atechdotdev/Atech-crab/atech/cad/review.png

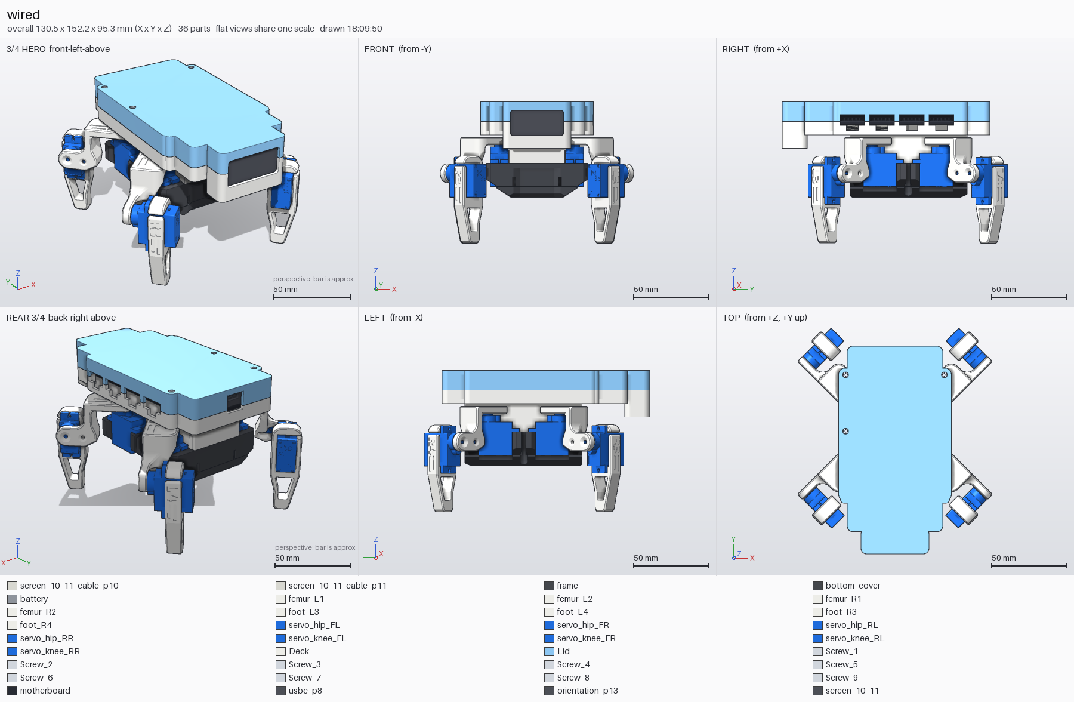
atech/cad/review.png
