atechdotdev/Atech-crab/atech/docs/img/rear.png

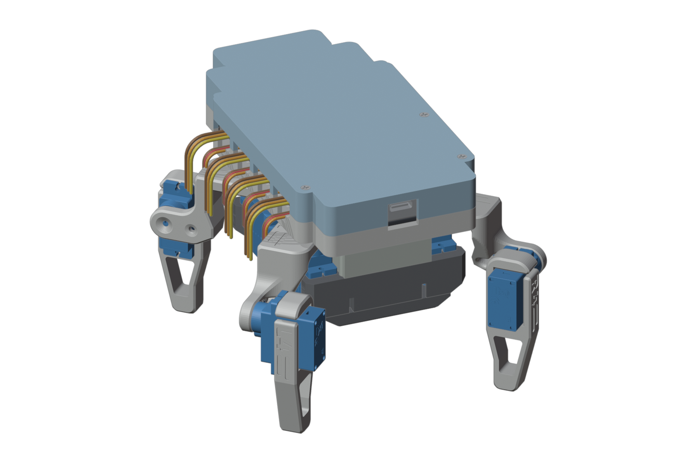
atech/docs/img/rear.png
