atechdotdev/Atech-crab/atech/docs/img/s1_base.png

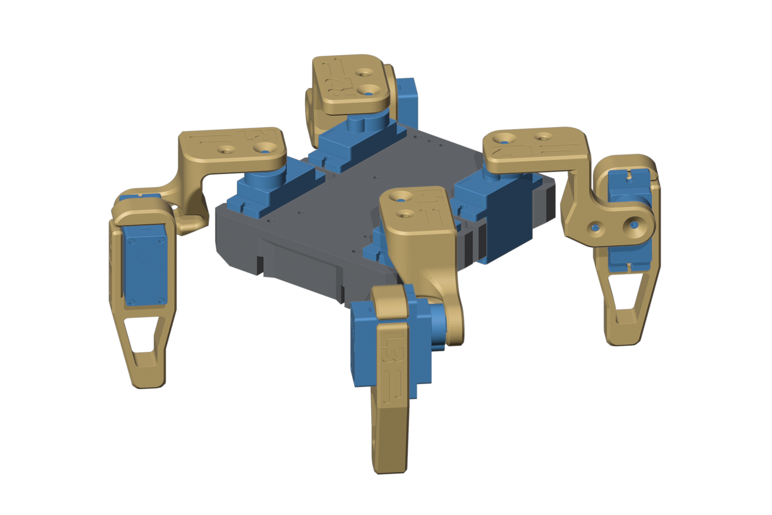
atech/docs/img/s1_base.png
