atechdotdev/Atech-crab/atech/docs/img/s2_glue.png

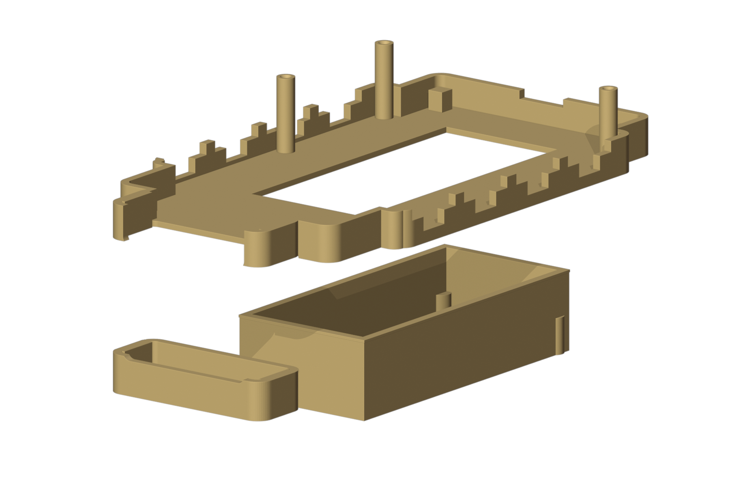
atech/docs/img/s2_glue.png
