atechdotdev/Atech-crab/atech/docs/img/s3_deck.png

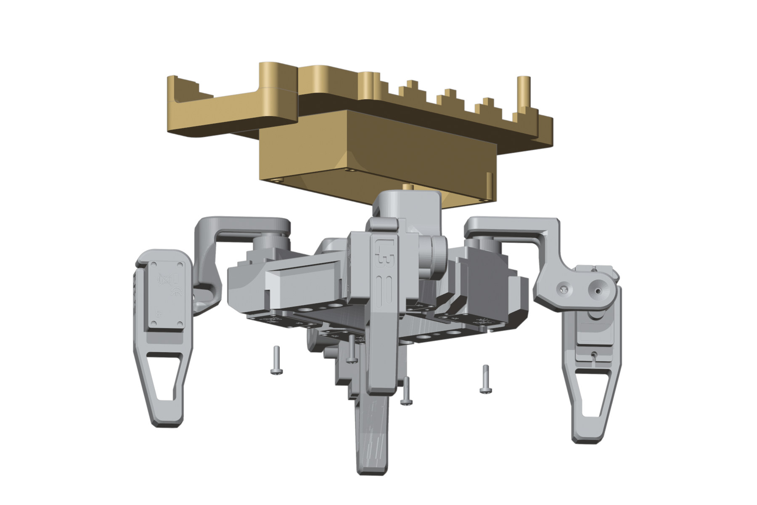
atech/docs/img/s3_deck.png
