atechdotdev/Atech-crab/atech/docs/img/s4_bottom.png

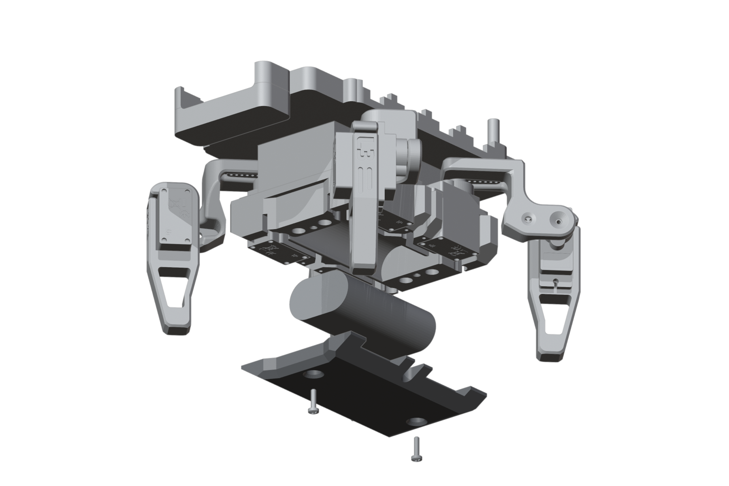
atech/docs/img/s4_bottom.png
