atechdotdev/Atech-crab/atech/docs/img/s5_board.png

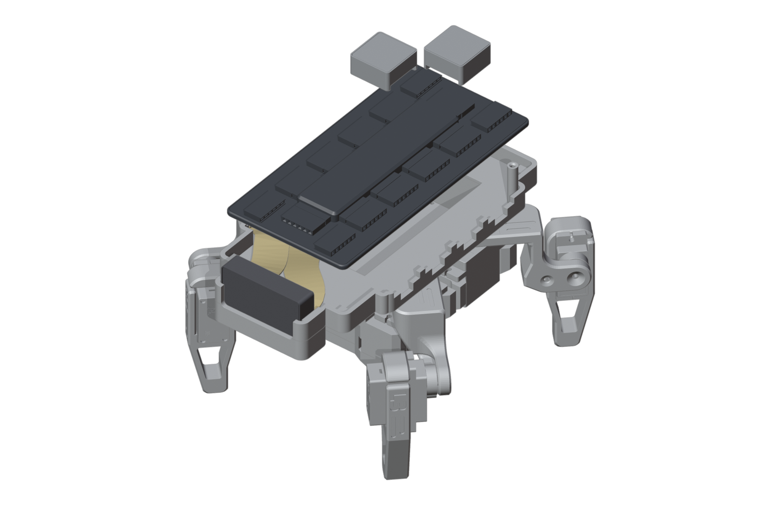
atech/docs/img/s5_board.png
