atechdotdev/Atech-crab/atech/docs/img/s6_slots_left.png

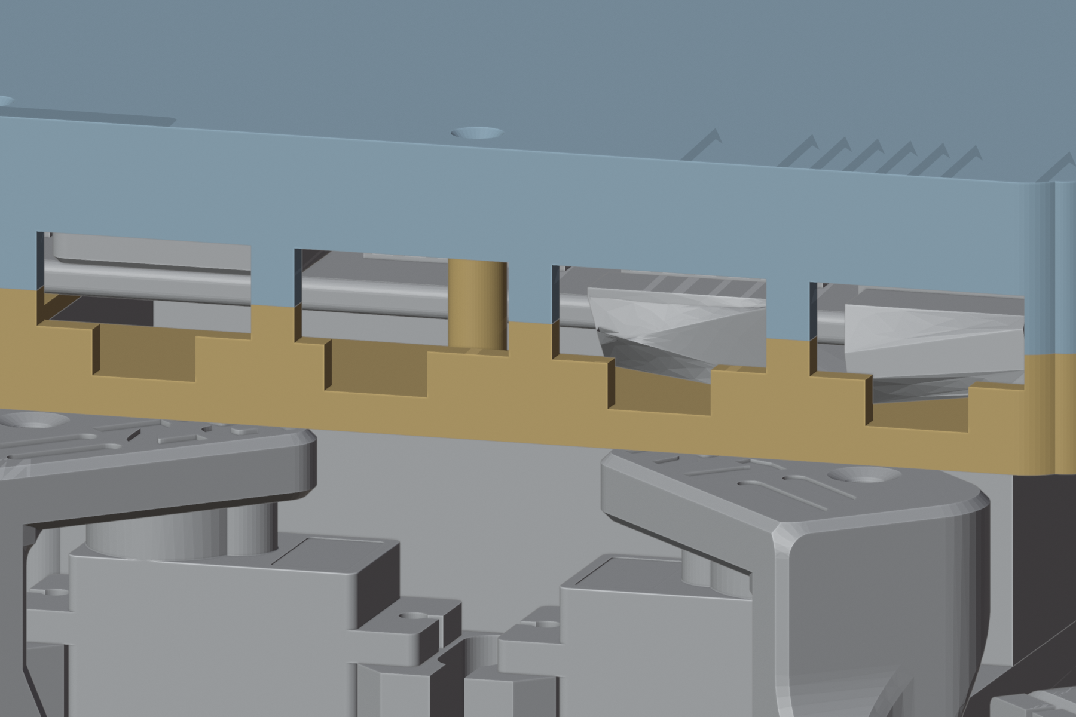
atech/docs/img/s6_slots_left.png
