atechdotdev/Atech-crab/atech/docs/img/s6_wires.png

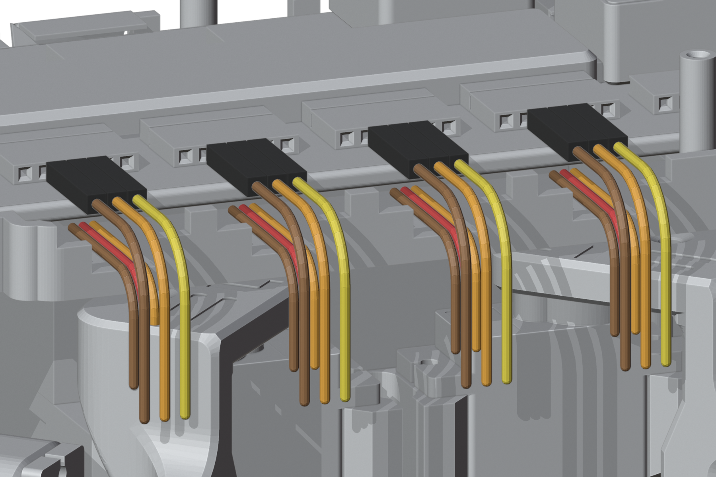
atech/docs/img/s6_wires.png
