atechdotdev/Atech-crab/atech/docs/img/s7_lid.png

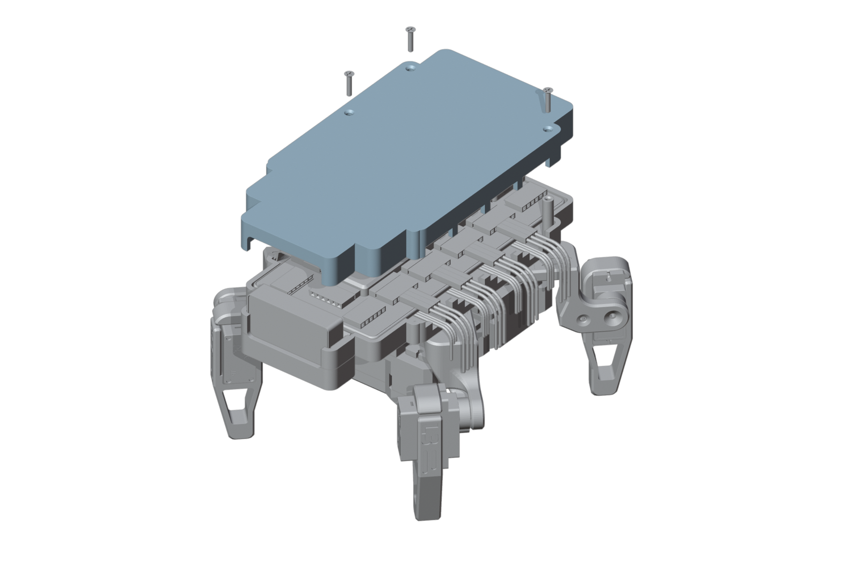
atech/docs/img/s7_lid.png
