atechdotdev/Atech-crab/atech/docs/img/s7_usb.png

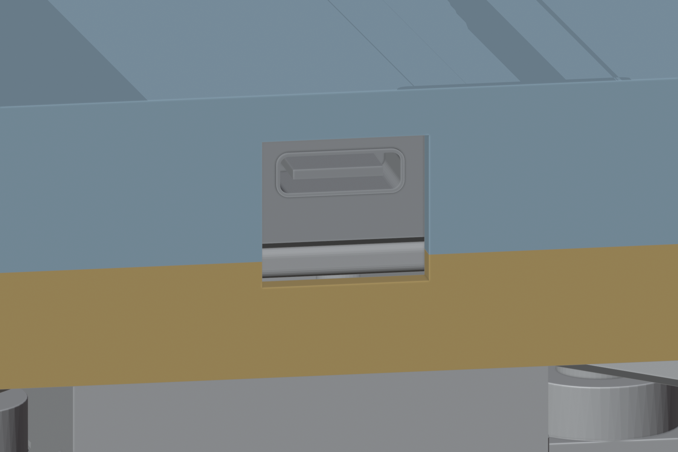
atech/docs/img/s7_usb.png
