atechdotdev/Atech-crab/atech/docs/img/parts.png

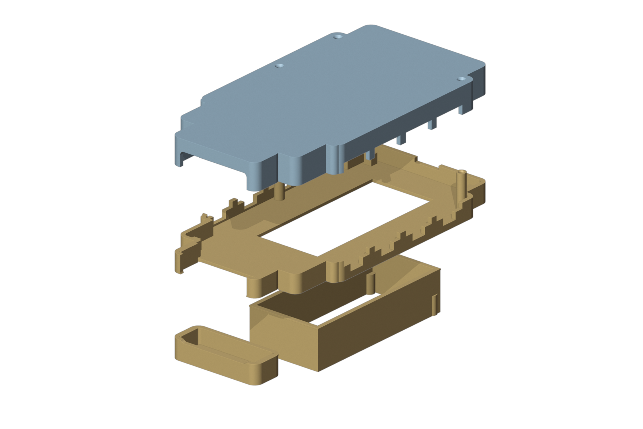
atech/docs/img/parts.png
