atechdotdev/Atech-crab/atech/print/gcode/atech_crab_pla_h2d.gcode.3mf

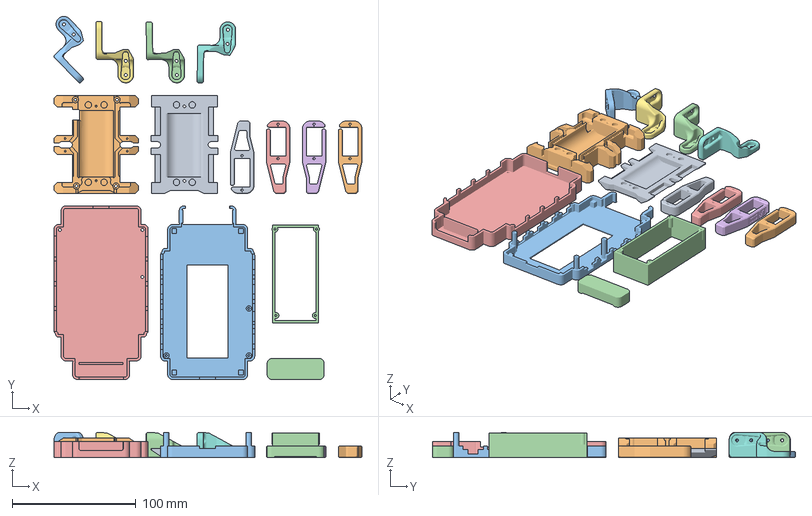
[picture p15: CAD file, 2026-11-03]
atech/print/gcode/atech_crab_pla_h2d.gcode.3mf
248.5 x 293.0 x 20.3 mm
Bottom-Cover-v121.stl
Internal-Frame-v121.stl
L1-v117.stl
L2-v117.stl
L3-v117.stl
L4-v117.stl
R1-v117.stl
R2-v117.stl
R3-v117.stl
R4-v117.stl
deck_part1_plate.stl
deck_part2_spine_and_head.stl
lid_print_upside_down.stl
