atechdotdev/Atech-crab/atech/print/stl/lid_print_upside_down.stl

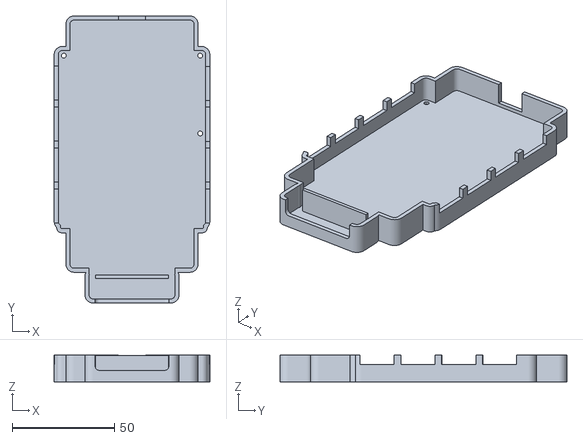
[picture p16: CAD file, 2026-11-03]
atech/print/stl/lid_print_upside_down.stl
76.0 x 140.2 x 13.1
