atechdotdev/Atech-crab/atech/print/gcode/atech_crab_pla_p2s_plate1.gcode.3mf

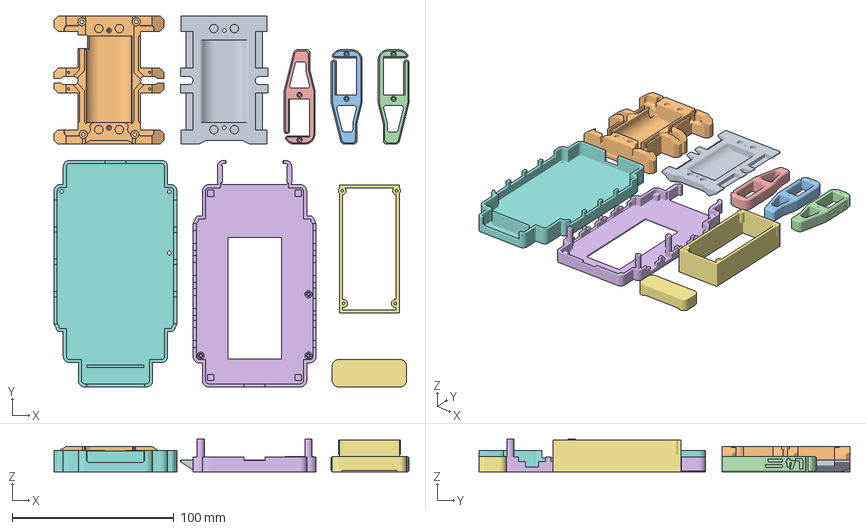
[picture p17: CAD file, 2026-11-03]
atech/print/gcode/atech_crab_pla_p2s_plate1.gcode.3mf
219.5 x 229.4 x 20.2 mm
Bottom-Cover-v121.stl
Internal-Frame-v121.stl
L3-v117.stl
L4-v117.stl
R3-v117.stl
deck_part1_plate.stl
deck_part2_spine_and_head.stl
lid_print_upside_down.stl
