atechdotdev/Atech-crab/atech/print/stl/deck_part1_plate.stl

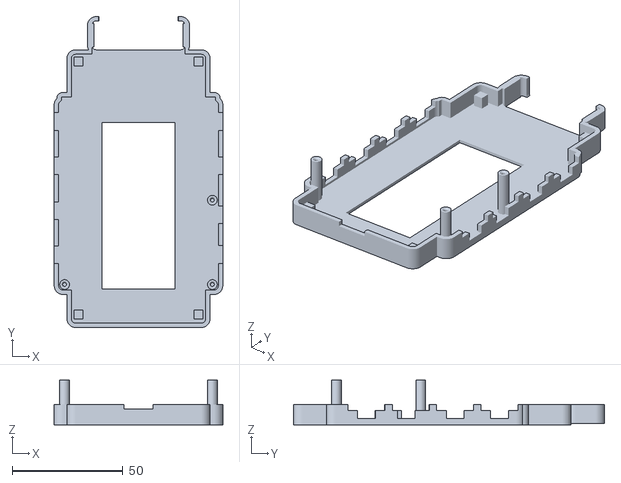
[picture p18: CAD file, 2026-11-03]
atech/print/stl/deck_part1_plate.stl
76.0 x 140.2 x 20.2
