atechdotdev/Atech-crab/atech/print/stl/deck_part2_spine_and_head.stl

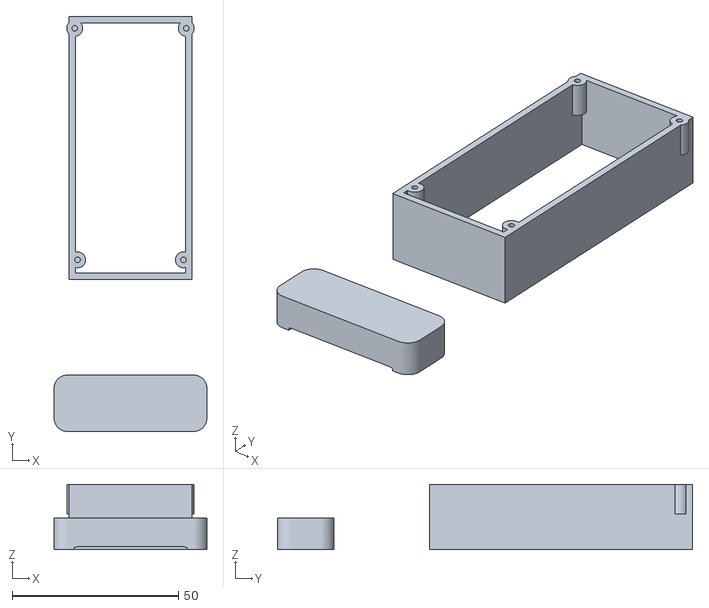
[picture p20: CAD file, 2026-11-02]
atech/print/stl/deck_part2_spine_and_head.stl
46.0 x 124.9 x 19.7
