atechdotdev/Atech-crab/atech/print/gcode/atech_crab_pla_x2d_plate2.gcode.3mf

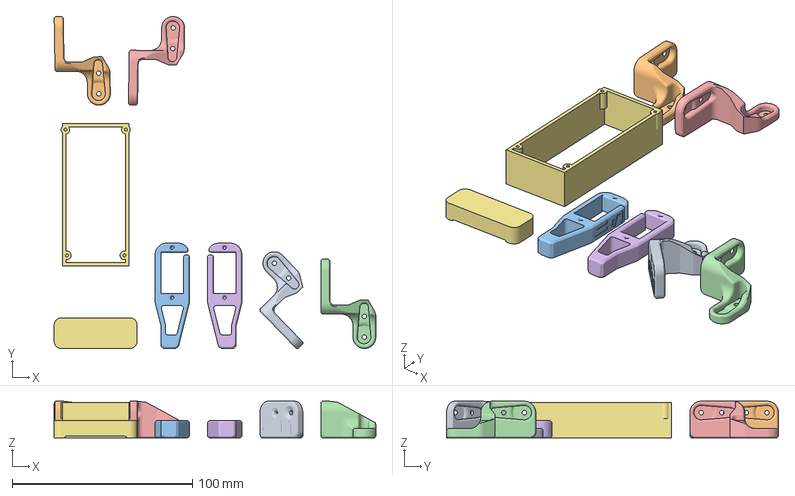
[picture p21: CAD file, 2026-11-03]
atech/print/gcode/atech_crab_pla_x2d_plate2.gcode.3mf
178.4 x 184.1 x 20.3 mm
L1-v117.stl
L2-v117.stl
L4-v117.stl
R1-v117.stl
R2-v117.stl
R4-v117.stl
deck_part2_spine_and_head.stl
