atechdotdev/Atech-crab/atech/print/stl/L3-v117.stl

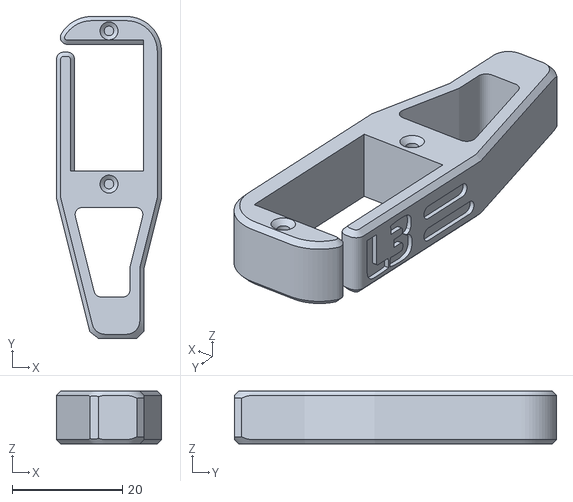
[picture p22: CAD file, 2026-11-02]
atech/print/stl/L3-v117.stl
19.0 x 58.4 x 9.53
