atechdotdev/Atech-crab/atech/print/gcode/atech_crab_pla_p2s_plate2.gcode.3mf

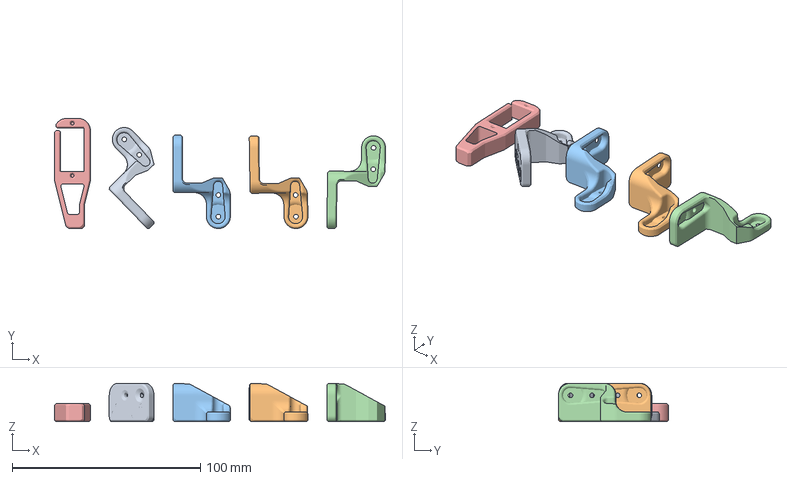
[picture p23: CAD file, 2026-11-03]
atech/print/gcode/atech_crab_pla_p2s_plate2.gcode.3mf
175.7 x 58.4 x 20.3 mm
L1-v117.stl
L2-v117.stl
R1-v117.stl
R2-v117.stl
R4-v117.stl
