atechdotdev/Atech-crab/atech/print/stl/R1-v117.stl

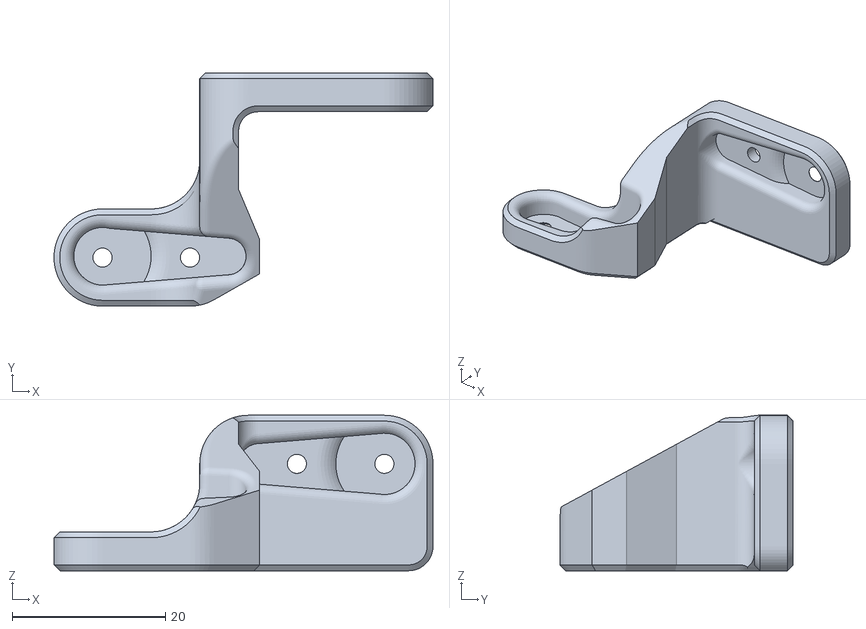
[picture p24: CAD file, 2026-11-02]
atech/print/stl/R1-v117.stl
49.5 x 30.5 x 20.3
