atechdotdev/Atech-crab/atech/print/stl/L1-v117.stl

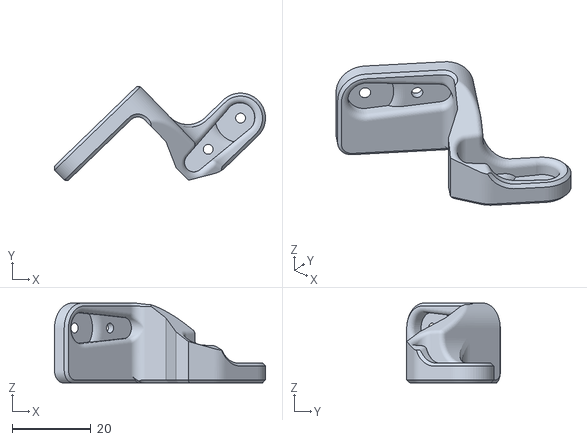
[picture p26: CAD file, 2026-11-02]
atech/print/stl/L1-v117.stl
53.6 x 23.8 x 20.3
