atechdotdev/Atech-crab/atech/print/stl/R2-v117.stl

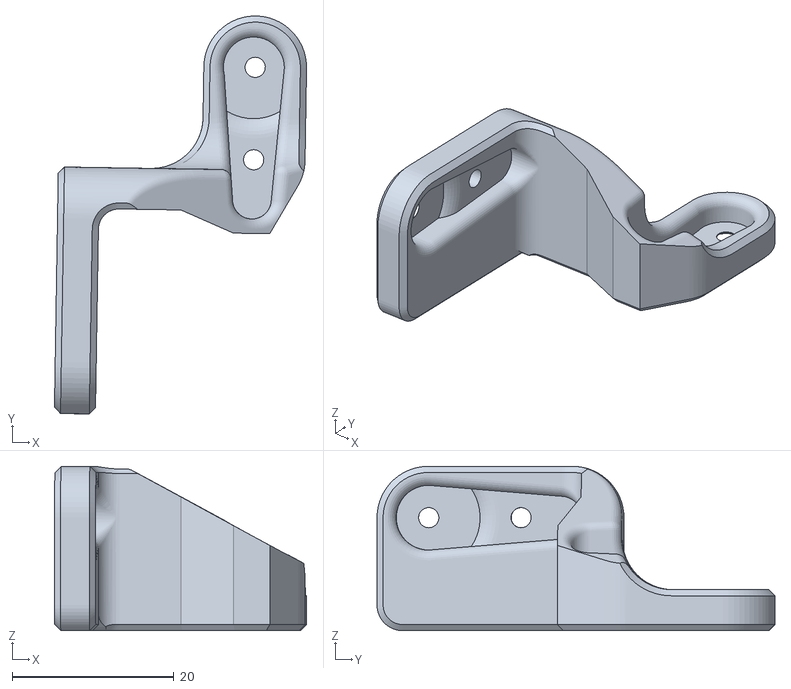
[picture p27: CAD file, 2026-11-02]
atech/print/stl/R2-v117.stl
31.2 x 49.2 x 20.3
