atechdotdev/Atech-crab/atech/print/stl/Internal-Frame-v121.stl

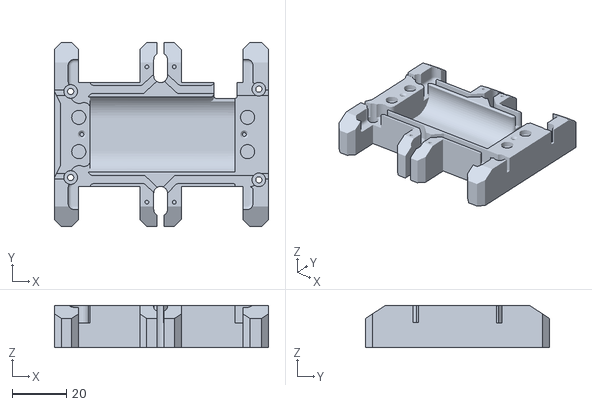
[picture p28: CAD file, 2026-11-02]
atech/print/stl/Internal-Frame-v121.stl
79.2 x 68.1 x 15.7
