atechdotdev/Atech-crab/atech/print/stl/Bottom-Cover-v121.stl

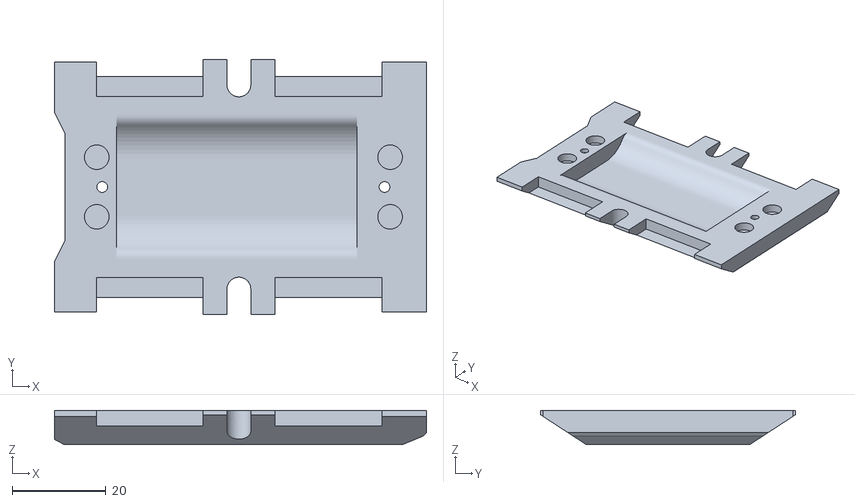
[picture p29: CAD file, 2026-11-02]
atech/print/stl/Bottom-Cover-v121.stl
79.2 x 54.2 x 7.27
