atechdotdev/Atech-crab/(list of files, cad)

Other CAD files:
atech/print/stl/L4-v117.stl
atech/print/stl/L2-v117.stl
atech/print/stl/R3-v117.stl
atech/print/stl/R4-v117.stl
