atechdotdev/Atech-crab/(commit log)

2026-11-02 Sesame on Atech: firmware, print files, assembly guide
    atech/ runs Sesame on an Atech 14-port board: the servos plug straight into
    ports 2-5 (two per port), an Atech screen shows the face, and a motion sensor
    holds the walk's heading.
    - firmware/: project.yaml for the Atech SDK, written by make_firmware.py from
    this repository's firmware/movement-sequences.h; sg90_pair servo module.
    Builds and runs on the SDK's emulated board; not yet run on a built robot.
    - print/: the 13 parts and Bambu PLA files (H2S, H2D, X2D, P2S); the deck and
    lid (Atech Atelier) have wire openings (v3). Not yet printed.
    - cad/, docs/: the deck/lid CAD, assembly PDF and video.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
    [Bottom-Cover-v121.stl, Internal-Frame-v121.stl, L1-v117.stl, L2-v117.stl, L3-v117.stl, L4-v117.stl, R1-v117.stl, R2-v117.stl]
2026-11-03 Atech-crab: name, NOTICE, README intro
    Rename the Atech edition of Sesame to Atech-crab, add an Apache-2.0 NOTICE
    naming Sesame (Dorian Todd) as the origin and listing what changed, and put
    an Atech-crab introduction above Sesame's original README.
    [atech_crab_pla_h2d.gcode.3mf, atech_crab_pla_h2s.gcode.3mf, atech_crab_pla_p2s_plate1.gcode.3mf, atech_crab_pla_p2s_plate2.gcode.3mf, atech_crab_pla_x2d_plate1.gcode.3mf, atech_crab_pla_x2d_plate2.gcode.3mf]
2026-11-03 Assembly guide and video: titled Atech-crab
    The PDF and video still said "Sesame on Atech". Title, intro and the first
    step now say Atech-crab; the credit to Sesame (Dorian Todd, Apache-2.0) stays.
2026-11-03 Deck and lid v4: wire openings on both sides; a 3D printing guide
    The slots and SG90 lead notches were only on the right (ports 2-5). v4 cuts the
    same ones into the left wall (ports 10-13), wall only: the lid-screw post at
    (-33.3, -2.5) stands inside it, and port 12's notch sits 2 mm back to clear it.
    Deck part 1 and the lid only; re-sliced for H2S, H2D, X2D, P2S (check.py OK).
    atech/print/README.md replaces README.txt: settings, every part with its
    orientation, the openings, and the ready-to-print Bambu files.
    The left openings were cut into the v3 print meshes (cad/cut_openings_left.py);
    sesame_atech_wired.py has the same boxes but was not re-run. Not printed yet.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
    [atech_crab_pla_h2d.gcode.3mf, atech_crab_pla_h2s.gcode.3mf, atech_crab_pla_p2s_plate1.gcode.3mf, atech_crab_pla_p2s_plate2.gcode.3mf, atech_crab_pla_x2d_plate1.gcode.3mf, atech_crab_pla_x2d_plate2.gcode.3mf, deck_part1_plate.stl, lid_print_upside_down.stl]
2026-11-03 Assembly guide and video for v4: slots on both sides
    The PDF gets a close-up of the new left-side slots (ports 10-13) in step 6 and
    says v4; every picture and the video are re-rendered with the v4 deck and lid
    (the video's frames swapped in under the same titles). The v4 CAD
    (cad/sesame_atech_wired.py) now builds and passes Atelier's check.
