atechdotdev/Atech-crab/(notices)

Notices in the files:
README.md:
License: APACHE2.0
